bendixsonnenberg/watering_controller/ERRORCODES.md

# Errors that can be generated by the rp controller
this is aspirational 

## codes
 XX represelnts the id of the sensor

|code| description|
|-----|---|
|0000| booted(power cycled)|
|0001| pump not working, water level not rising|
|0010| water reserve empty|
|0011| soil moisture not increasing anywhere|
|01XX|sensor is not communicating anymore|
|02XX| moisture level unrealisitc| 
|0404| no internet connection|
|05YY| first bit 0 represents rec, first bit 1 tec(from can)|
|06XX| sub freezing temps mesured at that sensor|
|0699| temp sensor failure|
