bendixsonnenberg/watering_controller/(threads)

Thread 2 (2025-06-10):

RGB LED for status signals and party mode for fun

DoktorWussow, 2025-06-10:
LED with 4 connectors used for status signals and a party mode for fun.

Mayby random colours derieved from the ID of the corrospondig STM32

bendixsonnenberg, 2025-06-10:
we have some space in the can contract for extra commands

DoktorWussow, 2025-06-10:
Can also be used for locating pot.
Got two ideas related to that topic:

1. after sending "locating" command to pot XXX, corresponding pot starts blinking with a random changing color (fixed pattern maybe easier?) for 15 sek and stops without any additional input. Could be useful for different light settings and a bit funny, also implementing No. 2 could be easier.

2. party mode could be a small variation, where the every pot start the "locating" routine. With some tricks using the individual ID maybe a sense of randomness can be created without needing any extra code. Only difference from No. 1 is the central controller sending the locating command to every pot. As there has to be a little time between each pot getting the command (so CAN is empty) there is a chance to add mentioned randomness (which pot is getting the command first). Pattern is probably catchable but not at first sight.

Closed 2025-07-14.

Thread 4 (2025-06-12):

System shutdown

DoktorWussow, 2025-06-12:
System was down at 7:10 pm. Restartet, second shutdown without any input. No clue where the issue lies, suspected connection problem to LCD. Improvised fix by restart.

DoktorWussow, 2025-06-13:
Another shutdown by 6pm. I believe the connection between raspberry and LCD is the main problem here.

bendixsonnenberg, 2025-06-13:
this commit might help with this, although i still do not know if we can figure out if the display is disconnected faf9a88

DoktorWussow, 2025-06-14:
Hardware Problem found, gonna fix and report back.

Closed 2025-06-16.

Thread 6 (2025-06-13):

water usage log

bendixsonnenberg, 2025-06-13:
log when the pump is running to refill the upper reservoir.  This should allow us to estimate the amount of water used.
TODO:

- [ ] implement analogue(therefore less prone to bugs) RS Latch for a pump to run. (2 sets of 2 nails as water detectors)
- [ ] connect a pin on the rp to the pump signal (possibly with voltage divider)
- [ ] log whenever the pump starts, it should output a fixed volume of water each time

Thread 7 (2025-06-13):

expand menu with settings for backoff time and watering time

bendixsonnenberg, 2025-06-13:
these options are still missing from the menu on the lcd
we will need to add another layer so that you select the sensor and then have to enter again to actually edit a setting.
this allows us to then use left/right to select settings

bendixsonnenberg, 2025-06-20:
@DoktorWussow please take a look at 21f75b2 and check if you are happy with the text that will be displayed on the lcd(line 180 ff.)

The current implementation increases the number of can messages that are sent, it may lead to slower response time in the interface. if that is an issue i have to get smarter with the can interactions

DoktorWussow, 2025-06-22:
For now we will work with these.

I'm a bit unhappy with "Bewaes" but got no alternatives.

As discussed, units would be helpful.

Closed 2025-06-22.

Thread 12 (2025-06-23):

Overflow detection

DoktorWussow, 2025-06-23:
By putting two wires in the pot saucer, a basic overflow detection by measuring resistance between those two. Watering would be stopped and an error code is set.

Self reset should be possible after resistance rises again. By that time, water should be sucked up in the pot and moisture should be detected correctly.

DoktorWussow, 2025-06-23:
Stainless wire would be best, maybe aluminum.

Thread 13 (2025-06-29):

IDs not working right

DoktorWussow, 2025-06-29:
After soldering to new schematic I tried different IDs. Lower IDs don't seem to work, definitely no #1 oder #11 (if my binary is correct).

#127/#128 work fine.

Closed 2025-07-14.

Thread 14 (2025-07-01):

Shutdown raspberry

DoktorWussow, 2025-07-01:
No apparent reason, stopped working at some point, Led not blinking. Restart fixed the issue.

- [x] Log reading

DoktorWussow, 2025-07-13:
New logfiles will be reviewed soon. High possibility that water got splashed on CAN distributor. As far as assessable no additional shutdown happened.

bendixsonnenberg, 2025-07-22:
since no new sudden shutdowns happened, I`m going to close this.

It probably was the water

Closed 2025-07-22.

Thread 15 (2025-07-18):

Central Controller Case

DoktorWussow, 2025-07-18:
I did some 3D sketching, you can find it [here](https://cad.onshape.com/documents/dbc6a240e19486c56bb5326b/w/e3311f923855798ad19fd912/e/721ee60b95c1d55c0f445f53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).

This concept is intended to be 3D printed. If there are any problems, please leave a comment. The hatch in the back is just a plate, i left it out intentionally.

bendixsonnenberg, 2025-07-19:
in order to make it more 3d printable, maybe taper this overhang so that it connects at a 45° angle on the inner side. Then printing with the face down should be possible

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

DoktorWussow, 2025-07-19:
Overhang added, attachment points for rp-controller will follow.

Thread 18 (2025-07-24):

Buttons not working right

DoktorWussow, 2025-07-24:
Don't have the right term at hand, buttons sometimes take single inputs as double or triple inputs.

bendixsonnenberg, 2025-08-28:
fixed in 832e4514b00ac6a1acb36e08fd0cc1d41d4031e3

DoktorWussow, 2025-08-28:
Debounce for "back" seems too short, still having double inputs. Maybe we have to go up to 150 ms?

Thread 20 (2025-07-27):

Power supply insufficient/Not an ideal solution?

DoktorWussow, 2025-07-27:
Not sure where the problem lies; while trying to refill the reservoir, I caught the CAN-distributor control-LED flashing. Seems like the power supply shutdown for some reason, maybe because different voltages where requested. Also I had difficulties to get the pump running. No idea why, needed like 3-6 tries.

bendixsonnenberg, 2025-07-27:
if both the pump and the raspberry are connected to the same power supply there is a possibility(or certainty with cheap power supplies) that the usb power is interrupted if the pump requests power. The solution would be to use 2 separate supplies for both.

Thread 23 (2025-08-24):

Ventilation detection

DoktorWussow, 2025-08-24:
Not sure if really needed, maybe some contact switches for the door, so manual ventilation is documented (also access monitoring just for fun?)

Lowest priority, just shot through my head. Door switch could be wired directly to raspberry, as its position is planned to be by the door.
