bendixsonnenberg/watering_controller/hardware/prototypes/sensor/Moisturesensor.kicad_pcb

## KiCad design BMW_E30_Gauge_Cluster_Early_Model/BMW_E30_Early_Cluster_Nexus/BMW_E30_Early_Cluster_Nexus.kicad_pcb

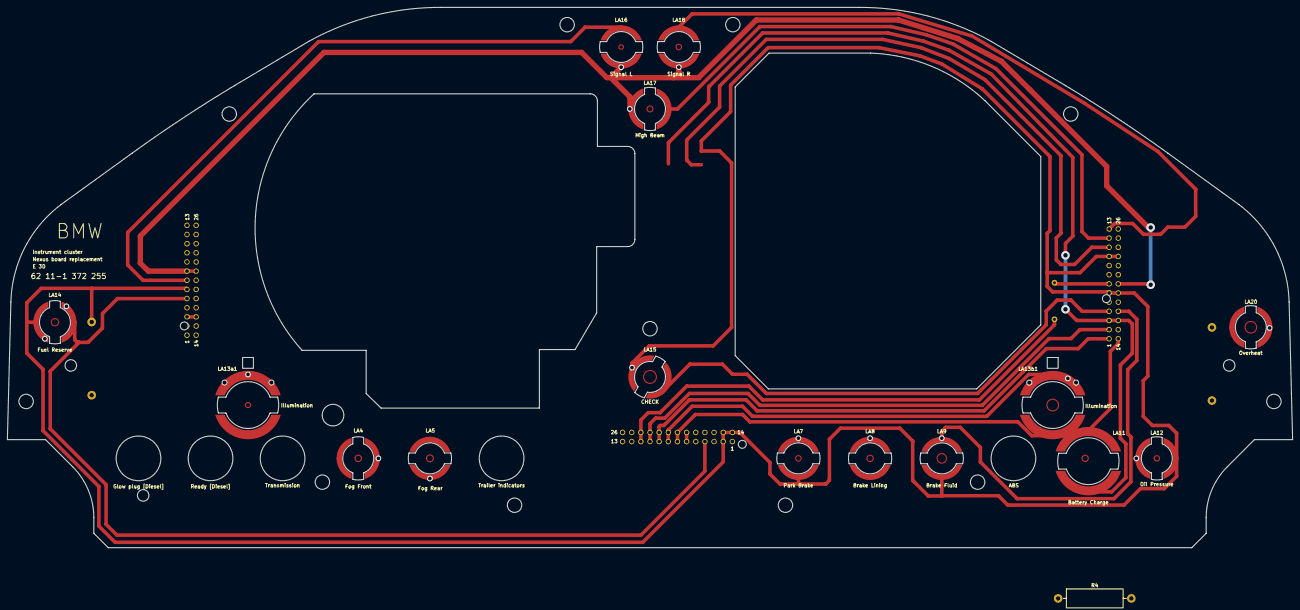
[picture p1: board BMW_E30_Early_Cluster_Nexus.kicad_pcb from above]

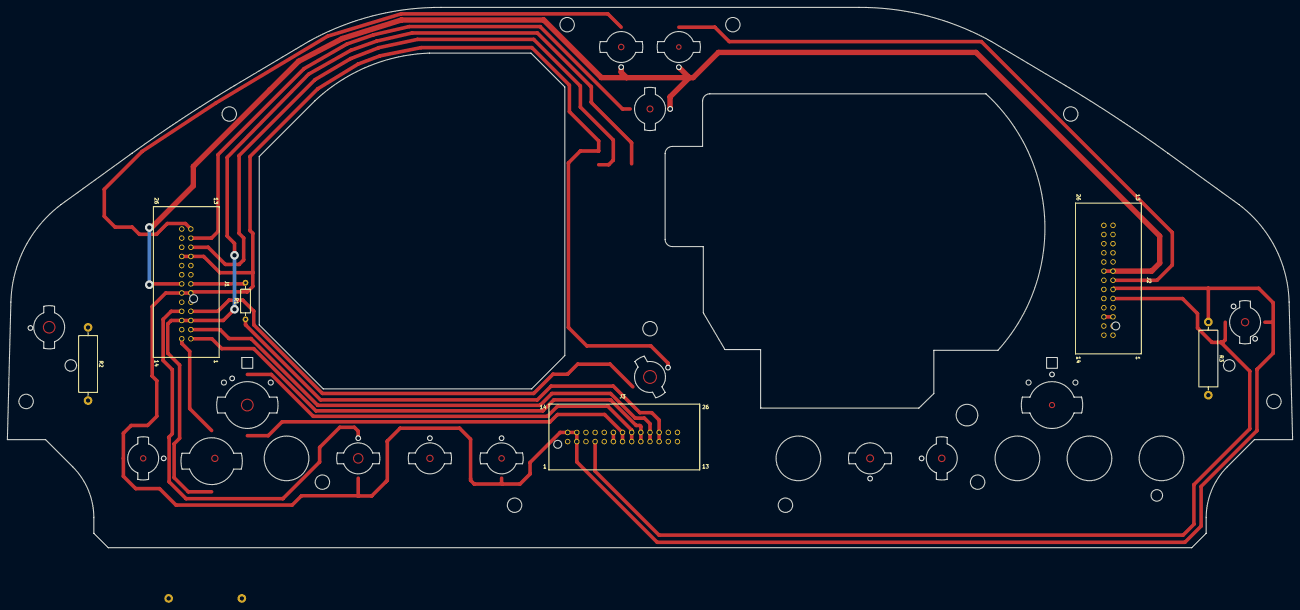
[picture p2: board BMW_E30_Early_Cluster_Nexus.kicad_pcb from below]

Board: 2 copper layers, 356.8 x 150.0 mm, 22 parts (6 on the bottom side), 24 nets.

Parts:
J1: C1 - Blue Connector; TE_827881-3
J2: C2 - White Connector; TE_827881-2
J3: C3 - Yellow Connector; TE_827881-1
LA4: Fog Front; 2721MF
LA5: Fog Rear; 2721MF
LA7: Park Brake; 2721MF
LA8: Brake Lining; 2721MF
LA9: Brake Fluid; 2721MF
LA11: Battery Charge; 2821MF
LA12: Oil Pressure; 2721MF
LA13a1, LA13b1: Illumination; 2821MF
LA14: Fuel Reserve; 2721MF
LA15: CHECK; 2721MF
LA16: Signal L; 2721MF
LA17: High Beam; 2721MF
LA18: Signal R; 2721MF
LA20: Overheat; 2721MF
R1: 16k; R_Axial_DIN0207_L6.3mm_D2.5mm_P10.16mm_Horizontal
R2, R3: 68R; R_Axial_DIN0516_L15.5mm_D5.0mm_P20.32mm_Horizontal
R4: 51R; R_Axial_DIN0516_L15.5mm_D5.0mm_P20.32mm_Horizontal

Connections:
+12 T15: J1.6, J1.10, J1.19, J1.23, J2.6, J3.2, J3.14, J3.15, LA7.2 (+), LA9.2 (+), LA12.2 (+), LA14.1 (-), LA15.1 (-), LA20.1 (-), R2.1, R3.1
+12 T15_ACC: J2.13, J3.13
+12 T30: J1.2, J3.10, J3.23
Brake_fluid_ind-: J1.17, LA9.1 (-)
Charge_Ind+: J1.14, LA11.1 (-), R4.1
Charge_ind-: J1.3, J1.16, LA11.2 (+), R4.2
Check_Control_ind: J1.4, LA15.2 (+)
Engine_spd_input: J3.11, J3.24, R1.1
Fog_ind+: J2.22, LA4.1 (-)
Fuel_level: J2.4, J3.5
Fuel_rate_input: J1.11, J3.25
GNDPWR: J1.20, J2.3, J2.8, J2.16, J2.21, J3.1, LA4.2 (+), LA5.1 (-), LA8.1 (-), LA16.2 (+), LA17.1 (-), LA18.2 (+)
High_beam_ind: J1.12, LA17.2 (+)
Illum+: J2.24, J3.8, J3.21, LA13a1.1 (-), LA13b1.1 (-)
Illum-: J2.23, J3.7, J3.20, LA13a1.2 (+), LA13b1.2 (+)
LH_ind: J2.7, LA16.1 (-)
Low_Fuel_ind-: J2.5, J3.4, LA14.2 (+)
Oil_pressure_ind-: J1.18, LA12.1 (-)
Overheat_ind-: J1.25, LA20.2 (+)
Park_brake_ind-: J2.1, J3.6, J3.19, LA7.1 (-)
RAW_RPM_input: J1.7, R1.2
RH_ind: J1.13, LA18.1 (-)
Rear_fog_ind+: J2.14, LA5.2 (+)
START: J1.1, J3.9, J3.22
