bendixsonnenberg/watering_controller/(commit log)

2025-04-02 rename code folder
    replace if let with iserr
    [main.rs]
2025-04-08 update spi sd card
2025-04-09 add more error reporting and make sd card work
    [main.rs]
2025-04-11 working blinky and can bus
2025-04-13 add adc to rp_controller
2025-04-16 add pcb layout
    [moisture_sensor.kicad_pcb, moisture_sensor.kicad_sch]
2025-04-19 made linear correction function more robust
    [main.rs]
2025-04-23 increase length of line for logging, suspect that this lead to crashes
    [main.rs]
2025-04-25 add bitmap for sensor tracking
2025-05-01 add generics to sensors
2025-05-01 current up to date state of the rp controller software
2025-05-04 change logging for sd card write errors
    [main.rs]
2025-05-04 can tx now checks if a send buffer is free before sending, receive waits for the receive interrupt
2025-05-05 fix losing send_channel messages by not finding a free tx buffer
    [main.rs]
2025-05-07 send settings to each new sensor when announced
2025-06-04 add rp controller schematic
    [rp_controller.kicad_pcb, rp_controller.kicad_sch]
2025-06-05 add getting the id from pin inputs
2025-06-05 remove adc
2025-06-05 add lcd display and menu buttons
2025-06-06 menu communication with sensors
2025-06-06 working version with one sensor
2025-06-06 delay announcement based on dev_id;
    sd_card for multiple sensors, dynamicly
    announcement delay to avoid clogging the can
    [main.rs]
2025-06-06 increase backoff time, reverse direction of rotary encoder
    [main.rs]
2025-06-06 add moisture to sensor window
2025-06-08 write time to sd card and fix order of moisture and threshold
    [sd_card.rs]
2025-06-10 Update README.md
    Some Structure added, mosfet added, headlines for future details prepared
2025-06-13 factor out moisture step size; set it to 10
    resolves #5
    [menu_implementation.rs]
2025-06-13 implement set light for a sensor
    for #3
2025-06-13 make the lcd interaction async,
    in case the display is disconnected, this will keep the rest of the device running.
    This will not help with reinitilizing the display so a restart is still required
2025-06-13 create new task for led_control, implement random
    relates to #2
2025-06-13 light up sensor led on focus
    whenever a sensor is selected, their led should shine red
    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
2025-06-20 add backoff_time, watering_time to menu
    relevant for #7
    this commit doubles the number of can frames sent for each populate call
    it may be that this leads to the menu interface seeming slower or losing connection more often
    if that is the case, we need to seperate the populate call out into multiple calls depending on the setting that needs to be updated/set
2025-06-20 increase sample time to get more stable values
2025-06-23 switch direction of scroll in new settings, add flake.lock
2025-06-23 Create Prototypes
2025-06-23 Revert "test"
    This reverts commit dfb4e7e7830218fc99c9b68645c307594ffb26df.
    the commit was mad by mistake
    [moisture_sensor.kicad_pcb, moisture_sensor.kicad_sch]
2025-06-23 prototype v2 schematic
    [Moisturesensor.kicad_pcb, Moisturesensor.kicad_sch]
2025-06-23 logfiles saved
    [1.CSV, 23062025.CSV]
2025-06-24 rework can contract
    consolidates the settings into a single command, also does that with the sensor readings
    Implement bitmaps to communicate the availabe sensor or light commands
    add convinence function that produces the embedded_can::Frame directely from CommandData
2025-06-28 implement new can api in sensor firmware
2025-06-28 implement the new can_contract api in can.rs for rp_controller
    not quite done yet, still need to fix stuff in other files that interact with this file,
    the function signatures have changed. This was duóne because it will be way cleaner although
    it does need more work in other locations
    [can.rs]
2025-07-04 log files input
    [04072025.CSV]
2025-07-13 add enviromental sensors
2025-07-13 add enviromental sensor to log file
2025-07-13 fix direction of sensor selction
    [sd_card.rs]
2025-07-13 fixed reversed order of backoff and watering time
    [main.rs]
2025-08-18 add information about release mode to moisture sensor
2025-08-26 add webinterface end button debouncing
